MarcosFontenlos/Inverted_Pendulum/PCB/ESP32-DEVKITC-32D/ESP32-DEVKITC-32D.step

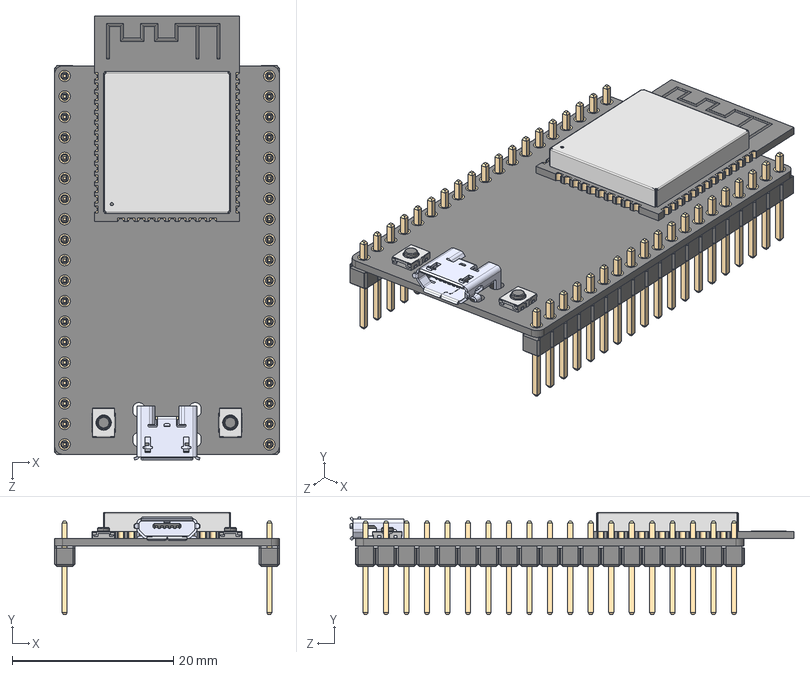
[picture p5: CAD file, 2026-10-22]
PCB/ESP32-DEVKITC-32D/ESP32-DEVKITC-32D.step
27.9 x 12.7 x 55.1 mm
board
header x 2
ESP32-WROOM-32D
micro usb
button x 2
