MarcosFontenlos/Inverted_Pendulum/PCB/ROB-14450/ROB-14450.step

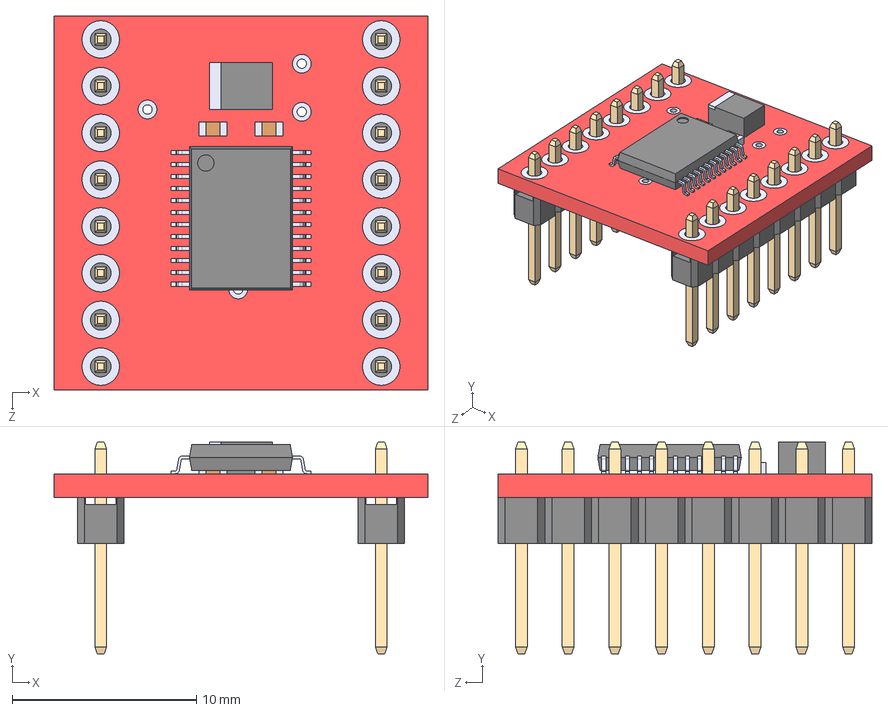
[picture p6: CAD file, 2026-10-22]
PCB/ROB-14450/ROB-14450.step
20.3 x 11.5 x 20.3 mm
