MarcosFontenlos/Inverted_Pendulum/Base_FreeCAD/Primer_modelo.FCStd

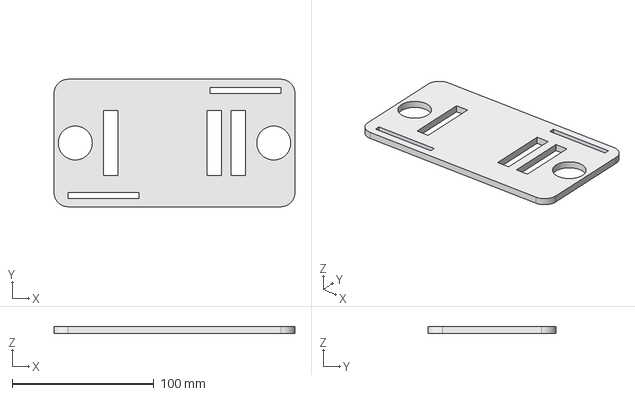
[picture p7: CAD file, 2026-10-22]
Base_FreeCAD/Primer_modelo.FCStd
170.0 x 90.0 x 5.00 mm
