MarcosFontenlos/Inverted_Pendulum/Base_FreeCAD/Modelo_2.FCStd

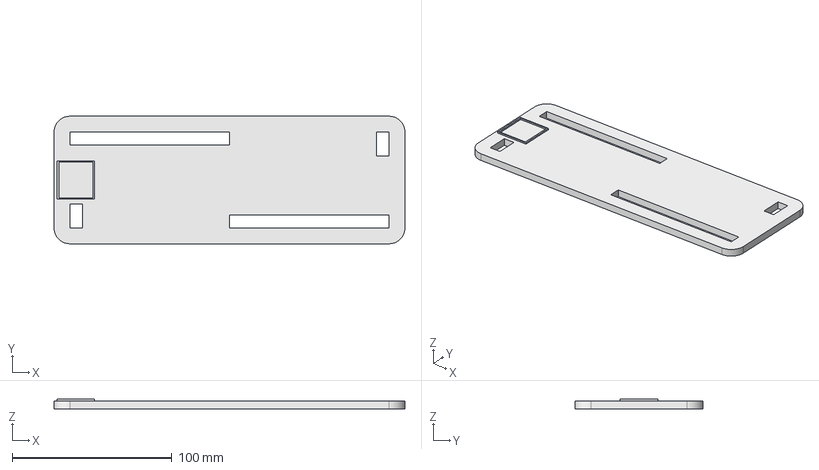
[picture p8: CAD file, 2026-10-22]
Base_FreeCAD/Modelo_2.FCStd
220.0 x 80.0 x 6.00 mm
