MarcosFontenlos/Inverted_Pendulum/Base_FreeCAD/Modelo_2_reformed.FCStd

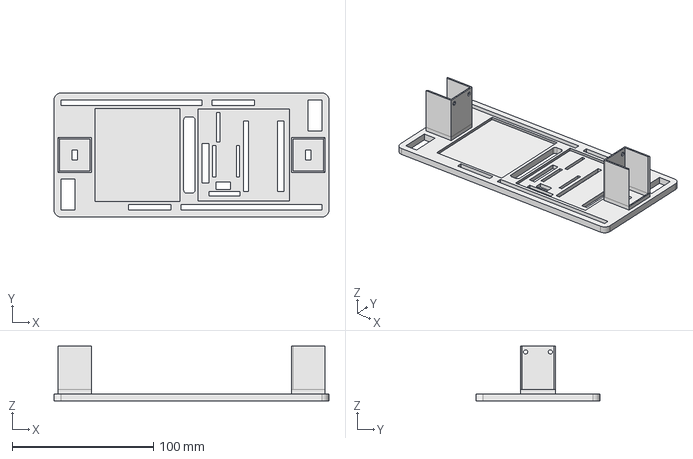
[picture p9: CAD file, 2026-10-22]
Base_FreeCAD/Modelo_2_reformed.FCStd
195.0 x 88.0 x 39.0 mm
