MarcosFontenlos/Inverted_Pendulum/Base_FreeCAD/Moddelo_FreeCad_Bruno.FCStd

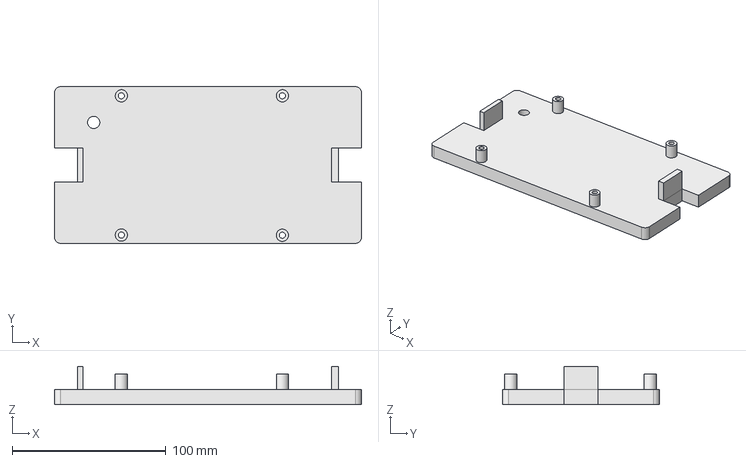
[picture p10: CAD file, 2026-10-22]
Base_FreeCAD/Moddelo_FreeCad_Bruno.FCStd
200.0 x 102.1 x 25.0 mm
