MarcosFontenlos/Inverted_Pendulum/(list of files, cad)

Other CAD files:
Base_FreeCAD/Modelo_2_reformed-Cuerpo_Fontenlos_Ferreiro_Marcos.stl
PCB/ESP32-DEVKITC/ESP32-DEVKITC.step
