MarcosFontenlos/Inverted_Pendulum/PCB/PCB.kicad_pcb

## KiCad design PCB/PCB.kicad_pcb (2026-10-22)

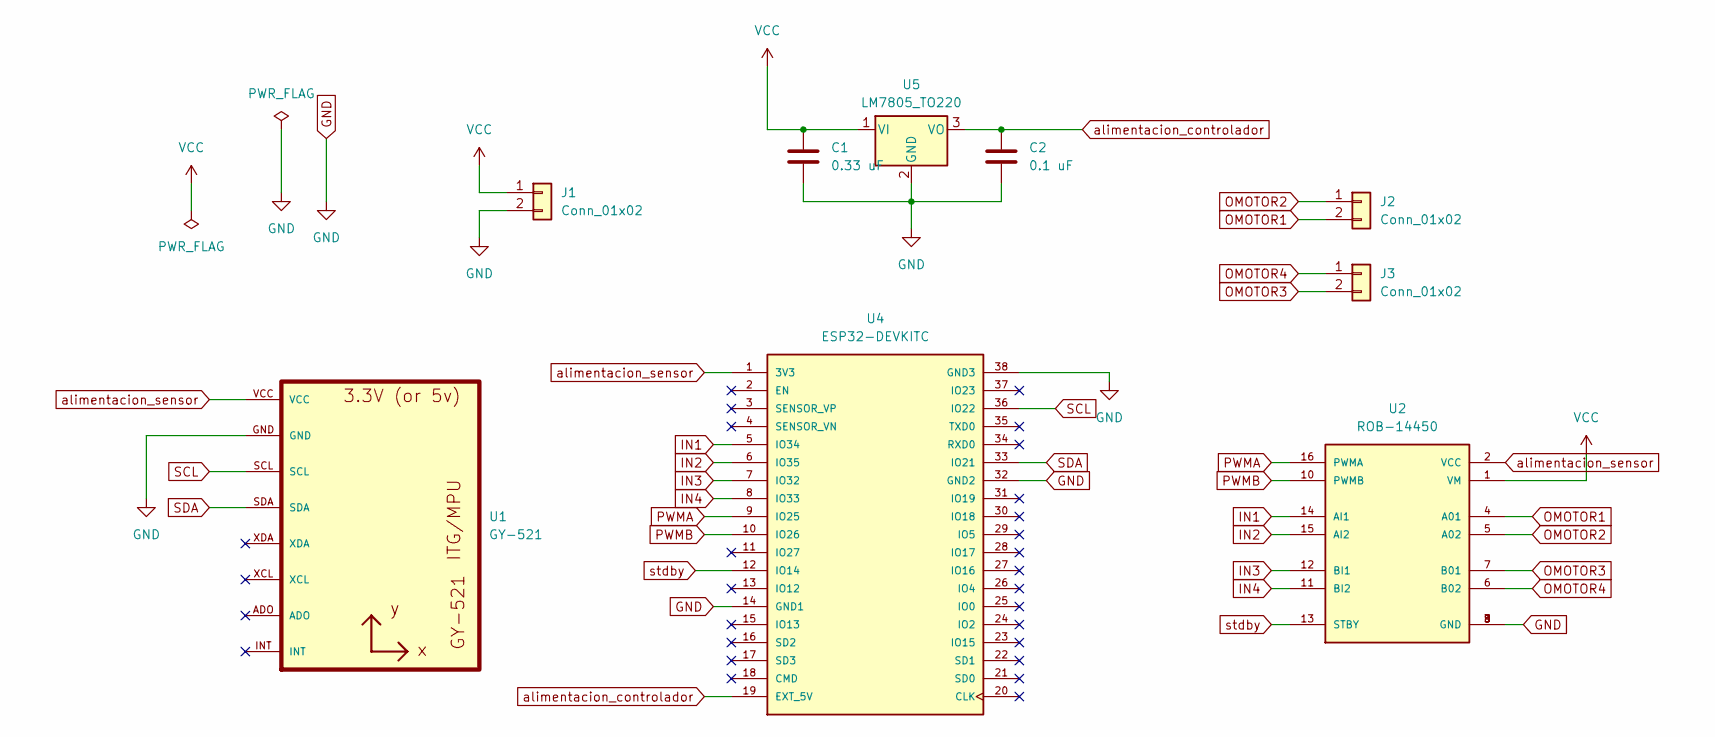
[picture p11: schematic PCB.kicad_sch]

Parts:
C1: 0.33 uF; C_Axial_L3.8mm_D2.6mm_P7.50mm_Horizontal
C2: 0.1 uF; C_Axial_L3.8mm_D2.6mm_P7.50mm_Horizontal
J1, J2, J3: Conn_01x02; PinSocket_1x02_P2.54mm_Vertical
U1: GY-521
U2: ROB-14450; MODULE_ROB-14450; PARTREV 11-13-17
U4: ESP32-DEVKITC; MODULE_ESP32-DEVKITC; PARTREV N/A
U5: LM7805_TO220; TO-220-3_Vertical

Connections:
GND: C1.2, C2.2, J1.2, U1.GND, U2.3 (GND), U2.8 (GND), U2.9 (GND), U4.14 (GND1), U4.32 (GND2), U4.38 (GND3), U5.2 (GND)
IN1: U2.14 (AI1), U4.5 (IO34)
IN2: U2.15 (AI2), U4.6 (IO35)
IN3: U2.12 (BI1), U4.7 (IO32)
IN4: U2.11 (BI2), U4.8 (IO33)
OMOTOR1: J2.2, U2.4 (A01)
OMOTOR2: J2.1, U2.5 (A02)
OMOTOR3: J3.2, U2.7 (B01)
OMOTOR4: J3.1, U2.6 (B02)
PWMA: U2.16 (PWMA), U4.9 (IO25)
PWMB: U2.10 (PWMB), U4.10 (IO26)
SCL: U1.SCL, U4.36 (IO22)
SDA: U1.SDA, U4.33 (IO21)
VCC: C1.1, J1.1, U2.1 (VM), U5.1 (VI)
alimentacion_controlador: C2.1, U4.19 (EXT_5V), U5.3 (VO)
alimentacion_sensor: U1.VCC, U2.2 (VCC), U4.1 (3V3)
stdby: U2.13 (STBY), U4.12 (IO14)

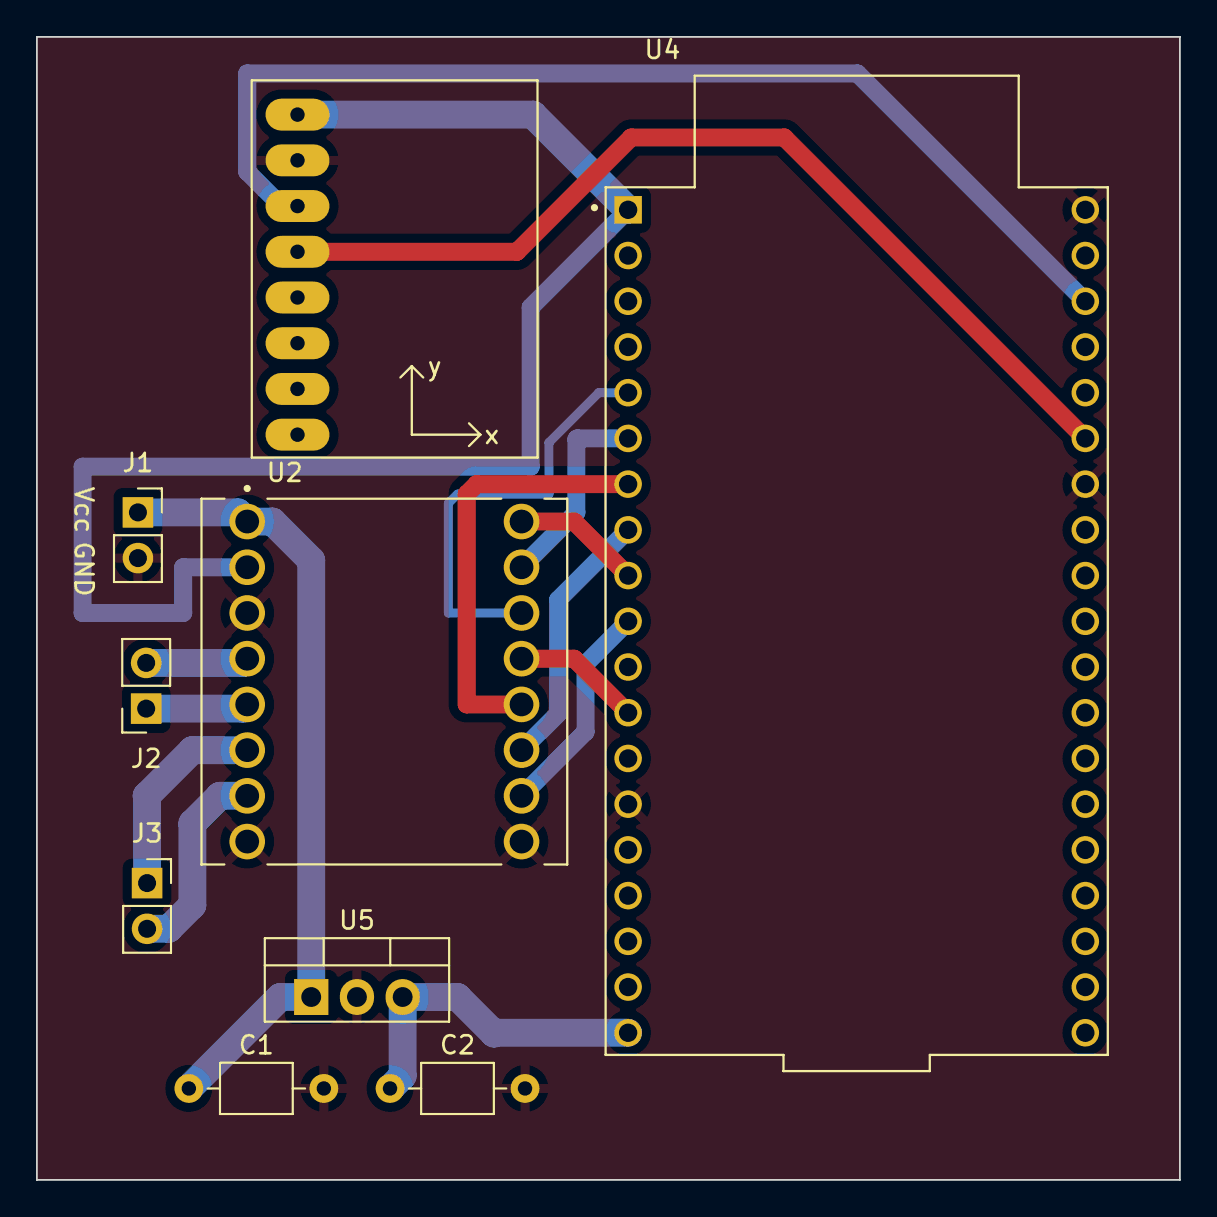
[picture p12: board PCB.kicad_pcb from above]

Board: 2 copper layers, 63.5 x 63.5 mm, 9 parts (0 on the bottom side), 17 nets.
