MarcosFontenlos/Inverted_Pendulum/Programas/PID/Control_PID/Control_PID.ino

#include <Wire.h>
#include <MPU6050.h>
#include <I2Cdev.h>

MPU6050 sensor;

// Definiciones de pines de motores
const int pinPWMA = 25;
const int pinAIN2 = 2;
const int pinAIN1 = 15;
const int pinBIN1 = 33;
const int pinBIN2 = 32;
const int pinPWMB = 26;
const int pinSTBY = 14;

// Variables del sensor MPU6050
float ang_x = 0, ang_y = 0;
float ang_x_prev = 0, ang_y_prev = 0;
float dt = 0;
long tiempo_prev = 0;

// Variables PID
float Kp = 15; // Ajusta estos 3 valores según sea necesario
float Ki = 0;
float Kd = 0;
float integral = 0.0;
float derivative = 0.0;
float previous_error = 0.0;

void setup() {
  Wire.begin();
  
  // Inicializar el sensor MPU6050 y verificar su estado
  sensor.initialize();
  if (!sensor.testConnection()) {
    while (1) {
      // Si el sensor no está conectado correctamente, parpadear un LED o detenerse aquí
      delay(500);
    }
  }

  // Configurar pines de motores
  pinMode(pinAIN2, OUTPUT);
  pinMode(pinAIN1, OUTPUT);
  pinMode(pinPWMA, OUTPUT);
  pinMode(pinBIN1, OUTPUT);
  pinMode(pinBIN2, OUTPUT);
  pinMode(pinPWMB, OUTPUT);
  pinMode(pinSTBY, OUTPUT);

  // Inicializar el tiempo
  tiempo_prev = millis();
}

void loop() {
  // Obtener datos del MPU6050
  int16_t ax, ay, az;
  int16_t gx, gy, gz;
  sensor.getAcceleration(&ax, &ay, &az);
  sensor.getRotation(&gx, &gy, &gz);

  // Calcular ángulos con el acelerómetro
  float accel_ang_x = atan(ay / sqrt(pow(ax, 2) + pow(az, 2))) * (180.0 / PI);
  float accel_ang_y = atan(-ax / sqrt(pow(ay, 2) + pow(az, 2))) * (180.0 / PI);

  // Calcular ángulo de rotación con giroscopio y filtro complementario
  dt = (millis() - tiempo_prev) / 1000.0;
  tiempo_prev = millis();
  ang_x = 0.98 * (ang_x_prev + (gx / 131.0) * dt) + 0.02 * accel_ang_x;
  ang_y = 0.98 * (ang_y_prev + (gy / 131.0) * dt) + 0.02 * accel_ang_y;

  ang_x_prev = ang_x;
  ang_y_prev = ang_y;

  // Control del péndulo invertido usando PID
  float desired_angle = 0.0; // Ángulo deseado para mantener el equilibrio
  float error = desired_angle - ang_x; // Calcular error

  integral += error * dt;
  derivative = (error - previous_error) / dt;

  float motor_speed = Kp * error + Ki * integral + Kd * derivative;

  // Controlar los motores
  enableMotors();
  moveMotor(pinPWMA, pinAIN1, pinAIN2, motor_speed);
  moveMotor(pinPWMB, pinBIN1, pinBIN2, motor_speed);

  // Actualizar el error anterior
  previous_error = error;

  delay(1); // Reducir el tiempo de espera para aumentar la frecuencia de muestreo
}

// Funciones adicionales
void moveMotor(int pinPWMA, int pinIN1, int pinIN2, float speed) {
  if (speed > 0) {
    digitalWrite(pinIN1, HIGH);
    digitalWrite(pinIN2, LOW);
    analogWrite(pinPWMA, speed);
  } else {
    digitalWrite(pinIN1, LOW);
    digitalWrite(pinIN2, HIGH);
    analogWrite(pinPWMA, -speed);
  }
}

void enableMotors() {
  digitalWrite(pinSTBY, HIGH);
}
