MarcosFontenlos/Inverted_Pendulum/Programas/Programas_auxiliares/Programa_calibracion_sensor/Programa_calibracion_sensor.ino

#include "MPU6050.h"
#include "Wire.h"

MPU6050 sensor;

int16_t ax, ay, az;
int16_t gx, gy, gz;

long f_ax, f_ay, f_az;
int p_ax, p_ay, p_az;
long f_gx, f_gy, f_gz;
int p_gx, p_gy, p_gz;
int counter = 0;

int ax_o, ay_o, az_o;
int gx_o, gy_o, gz_o;

void setup() {
  Serial.begin(57600);
  Wire.begin();
  sensor.initialize();

  if (sensor.testConnection())
    Serial.println("Sensor iniciado correctamente");

  else 
    Serial.println("Fallo al detectar el sensor");
    
  ax_o = sensor.getXAccelOffset();
  ay_o = sensor.getYAccelOffset();
  az_o = sensor.getZAccelOffset();
  gx_o = sensor.getXGyroOffset();
  gy_o = sensor.getYGyroOffset();
  gz_o = sensor.getZGyroOffset();

  Serial.println("Offsets:");
  Serial.print(ax_o); Serial.print("\t");
  Serial.print(ay_o); Serial.print("\t");
  Serial.print(az_o); Serial.print("\t");
  Serial.print(gx_o); Serial.print("\t");
  Serial.print(gy_o); Serial.print("\t");
  Serial.print(gz_o); Serial.print("\t");
  Serial.println("\nEnvie cualquier caracter para empezar la calibracion\n");

  while (true) {
    if (Serial.available()) break;
  }
  Serial.println("Calibrando, no mover IMU");
}

void loop() {
  sensor.getAcceleration(&ax, &ay, &az);
  sensor.getRotation(&gx, &gy, &gz);

  f_ax = f_ax - (f_ax >> 5) + ax;
  p_ax = f_ax >> 5;

  f_ay = f_ay - (f_ay >> 5) + ay;
  p_ay = f_ay >> 5;

  f_az = f_az - (f_az >> 5) + az;
  p_az = f_az >> 5;

  f_gx = f_gx - (f_gx >> 3) + gx;
  p_gx = f_gx >> 3;

  f_gy = f_gy - (f_gy >> 3) + gy;
  p_gy = f_gy >> 3;

  f_gz = f_gz - (f_gz >> 3) + gz;
  p_gz = f_gz >> 3;

  if (counter == 100) {
    Serial.print("Promedio:"); Serial.print("\t");
    Serial.print(p_ax); Serial.print("\t");
    Serial.print(p_ay); Serial.print("\t");
    Serial.print(p_az); Serial.print("\t");
    Serial.print(p_gx); Serial.print("\t");
    Serial.print(p_gy); Serial.print("\t");
    Serial.println(p_gz);

    if (p_ax > 0) ax_o--;
    else ax_o++;

    if (p_ay > 0) ay_o--;
    else ay_o++;

    if (p_az - 16384 > 0) az_o--;
    else az_o++;

    sensor.setXAccelOffset(ax_o);
    sensor.setYAccelOffset(ay_o);
    sensor.setZAccelOffset(az_o);

    if (p_gx > 0) gx_o--;
    else gx_o++;

    if (p_gy > 0) gy_o--;
    else gy_o++;

    if (p_gz > 0) gz_o--;
    else gz_o++;

    sensor.setXGyroOffset(gx_o);
    sensor.setYGyroOffset(gy_o);
    sensor.setZGyroOffset(gz_o);

    counter = 0;
  }
  counter++;
}
